marco-rabaioli/peltier-educational-kit/hardware/README.md

# Hardware

This folder contains all versions of the hardware-related files of the Peltier kit, including:

- **Schematics**: Electrical diagrams in PDF format.
- **PCB files**: Manufacturing files in Gerber format.
- **BOM**: Bill of Materials listing all components required to build the interface circuit.

The hardware has been designed to be simple, low-cost, and easily reproducible for educational purposes.
