marco-rabaioli/peltier-educational-kit/hardware/v0.1_educational/schematics/Schematic_Peltier_v0.1.pdf

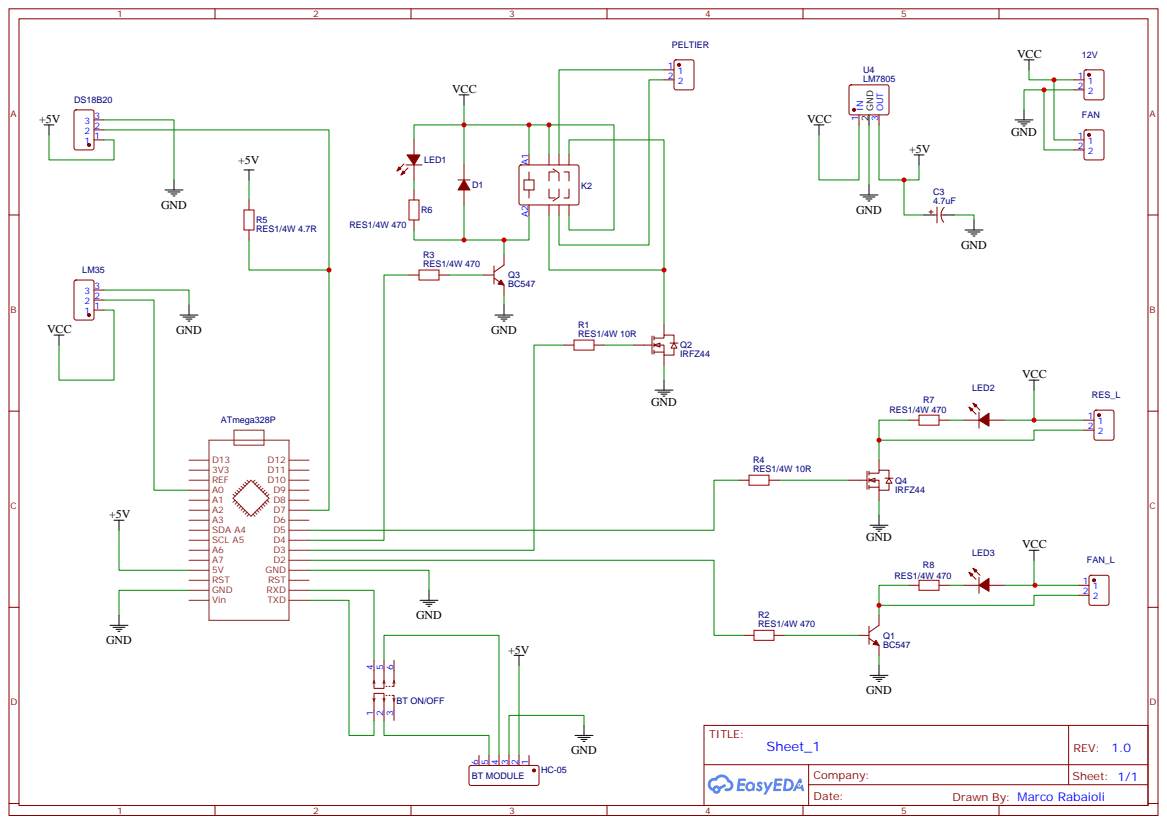
[picture p1: page 1]

Drawn By: Marco Rabaioli
